vdesmedt/Elgato-Key-Light-Air-Buttons/revisions.md

## Rev 0.9
PCB arrived on Oct 26 2026
### Issues
- Space between MX switches to allow for the cap
- Square corners
- LED Upside down (now lightning toward the back)
- Miss 5V test point
