vdesmedt/Elgato-Key-Light-Air-Buttons/EllagatoKeys.kicad_pcb

## KiCad design EllagatoKeys.kicad_pcb (2026-10-26)

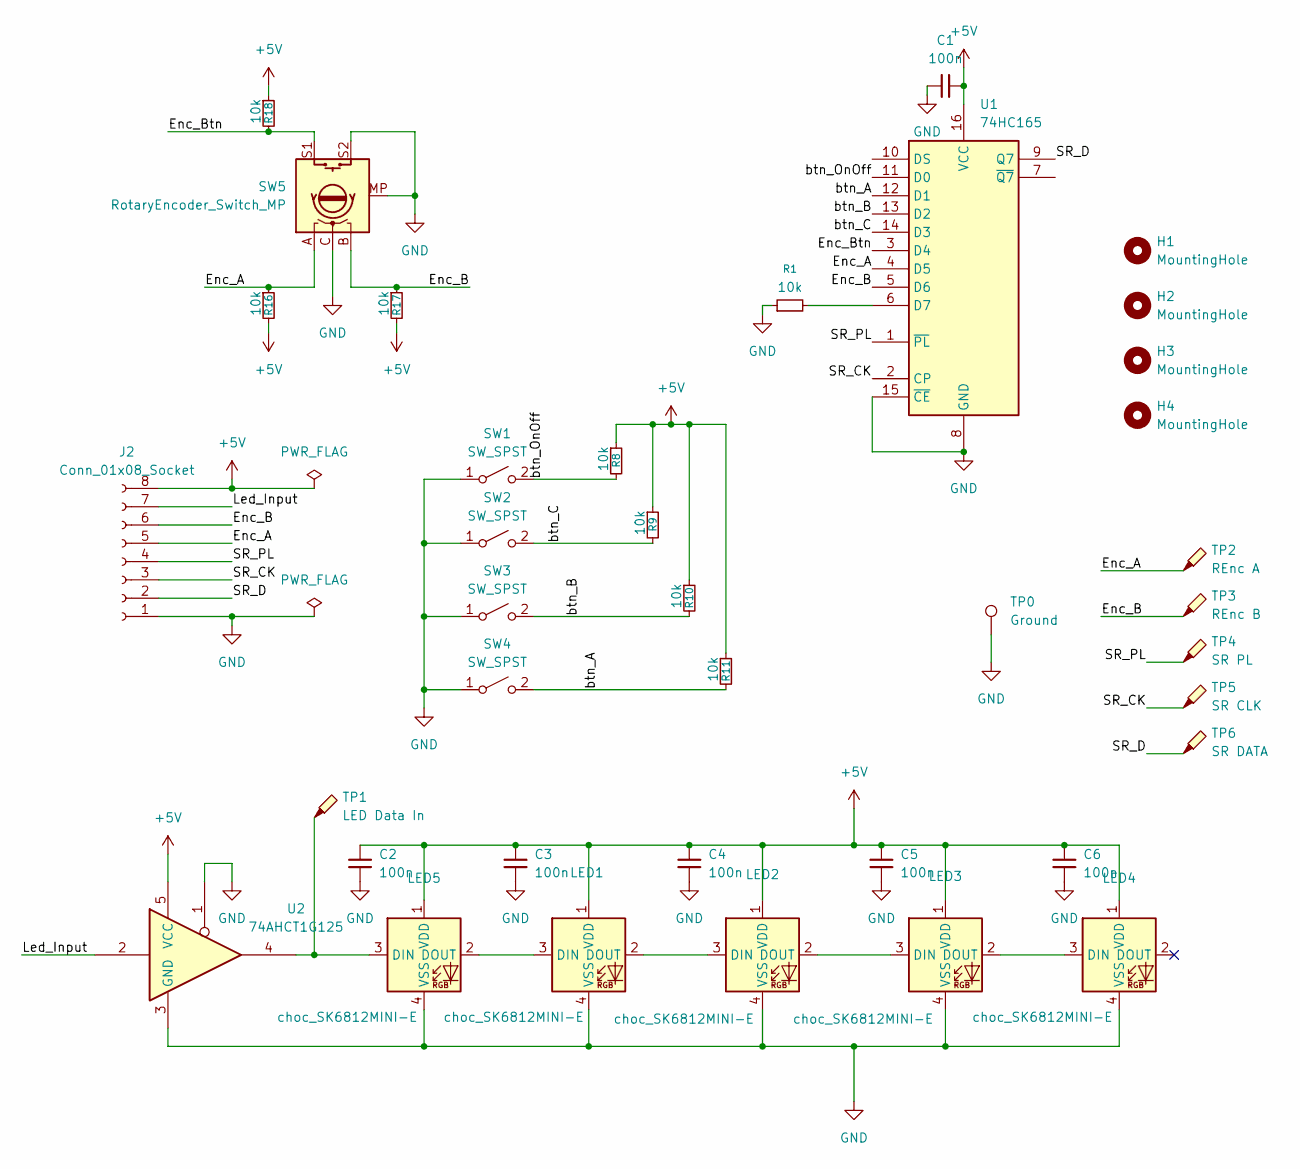
[picture p1: schematic EllagatoKeys.kicad_sch]

Parts:
C1, C2, C3, C4, C5, C6: 100n; C_0805_2012Metric_Pad1.18x1.45mm_HandSolder
H1, H2, H3, H4: MountingHole; MountingHole_2.7mm_M2.5
J2: Conn_01x08_Socket; PinHeader_1x08_P2.54mm_Horizontal
LED1, LED2, LED3, LED4, LED5: choc_SK6812MINI-E; LED_choc_6028R
R1, R8, R9, R10, R11, R16, R17, R18: 10k; R_0805_2012Metric_Pad1.20x1.40mm_HandSolder
SW1, SW2, SW3, SW4: SW_SPST; SW_Cherry_MX_1.00u_Plate
SW5: RotaryEncoder_Switch_MP; RotaryEncoder_Alps_EC11E-Switch_Vertical_H20mm
TP0: Ground; TestPoint_Keystone_5010-5014_Multipurpose
TP1: LED Data In; TestPoint_Keystone_5010-5014_Multipurpose
TP2: REnc A; TestPoint_Keystone_5010-5014_Multipurpose
TP3: REnc B; TestPoint_Keystone_5010-5014_Multipurpose
TP4: SR PL; TestPoint_Keystone_5010-5014_Multipurpose
TP5: SR CLK; TestPoint_Keystone_5010-5014_Multipurpose
TP6: SR DATA; TestPoint_Keystone_5010-5014_Multipurpose
U1: 74HC165; SOIC-16_3.9x9.9mm_P1.27mm
U2: 74AHCT1G125; SOT-23-5

Connections:
+5V: C1.2, C2.1, C3.1, C4.1, C5.1, C6.1, J2.8, LED1.1 (VDD), LED2.1 (VDD), LED3.1 (VDD), LED4.1 (VDD), LED5.1 (VDD), R8.1, R9.1, R10.1, R11.1, R16.2, R17.2, R18.1, U1.16 (VCC), U2.5 (VCC)
/Enc_A: J2.5, R16.1, SW5.A, TP2.1 (1_1), U1.4 (D5)
/Enc_B: J2.6, R17.1, SW5.B, TP3.1 (1_1), U1.5 (D6)
/Enc_Btn: R18.2, SW5.S1, U1.3 (D4)
/Led_Input: J2.7, U2.2
/SR_CK: J2.3, TP5.1 (1_1), U1.2 (CP)
/SR_D: J2.2, TP6.1 (1_1), U1.9 (Q7)
/SR_PL: J2.4, TP4.1 (1_1), U1.1 (~PL)
/btn_A: R11.2, SW4.2 (B), U1.12 (D1)
/btn_B: R10.2, SW3.2 (B), U1.13 (D2)
/btn_C: R9.2, SW2.2 (B), U1.14 (D3)
/btn_OnOff: R8.2, SW1.2 (B), U1.11 (D0)
GND: C1.1, C2.2, C3.2, C4.2, C5.2, C6.2, J2.1, LED1.4 (VSS), LED2.4 (VSS), LED3.4 (VSS), LED4.4 (VSS), LED5.4 (VSS), R1.1, SW1.1 (A), SW2.1 (A), SW3.1 (A), SW4.1 (A), SW5.C, SW5.MP, SW5.S2, TP0.1 (1_1), U1.8 (GND), U1.15 (~CE), U2.1, U2.3 (GND)
unnamed: LED1.3 (DIN), LED5.2 (DOUT)
unnamed: LED1.2 (DOUT), LED2.3 (DIN)
unnamed: LED2.2 (DOUT), LED3.3 (DIN)
unnamed: LED3.2 (DOUT), LED4.3 (DIN)
unnamed: LED5.3 (DIN), TP1.1 (1_1), U2.4
unnamed: R1.2, U1.6 (D7)

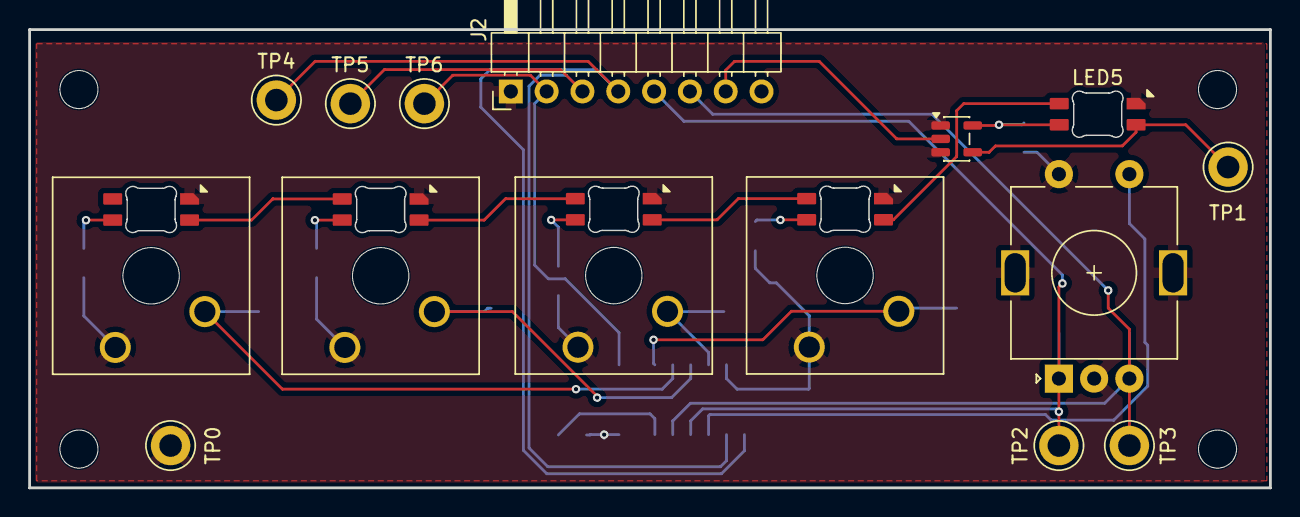
[picture p2: board EllagatoKeys.kicad_pcb from above]

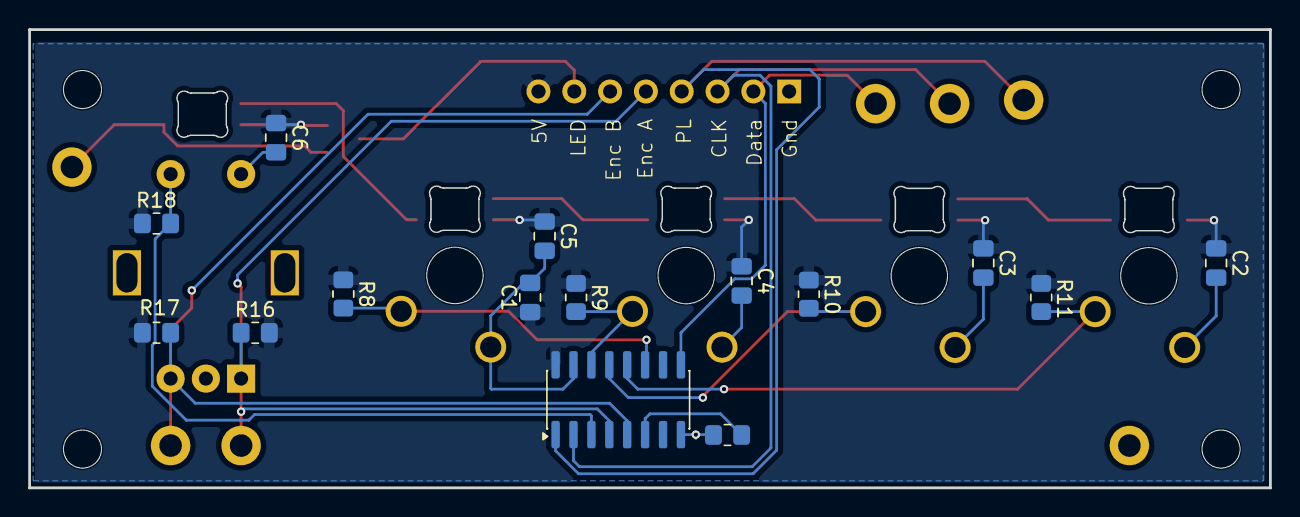
[picture p3: board EllagatoKeys.kicad_pcb from below]

Board: 2 copper layers, 88.0 x 32.5 mm, 38 parts (15 on the bottom side), 19 nets.
