vdesmedt/Elgato-Key-Light-Air-Buttons/(commit log)

2026-10-25 Production V1
    [EllagatoKeys.kicad_pcb, EllagatoKeys.kicad_sch]
2026-10-26 +Added Decoupling Cap to LED !!Added connection to VCC for LED2&3 !Restored compoenent labels
    [EllagatoKeys.kicad_pcb, EllagatoKeys.kicad_sch]
2026-10-26 Add initial revision notes for PCB
2026-10-26 Update revision notes for PCB issues
2026-10-26 Update issues list
    Removed mention of the 5V test point from issues list.
